monome/40h/monome40h_grid_layout.png

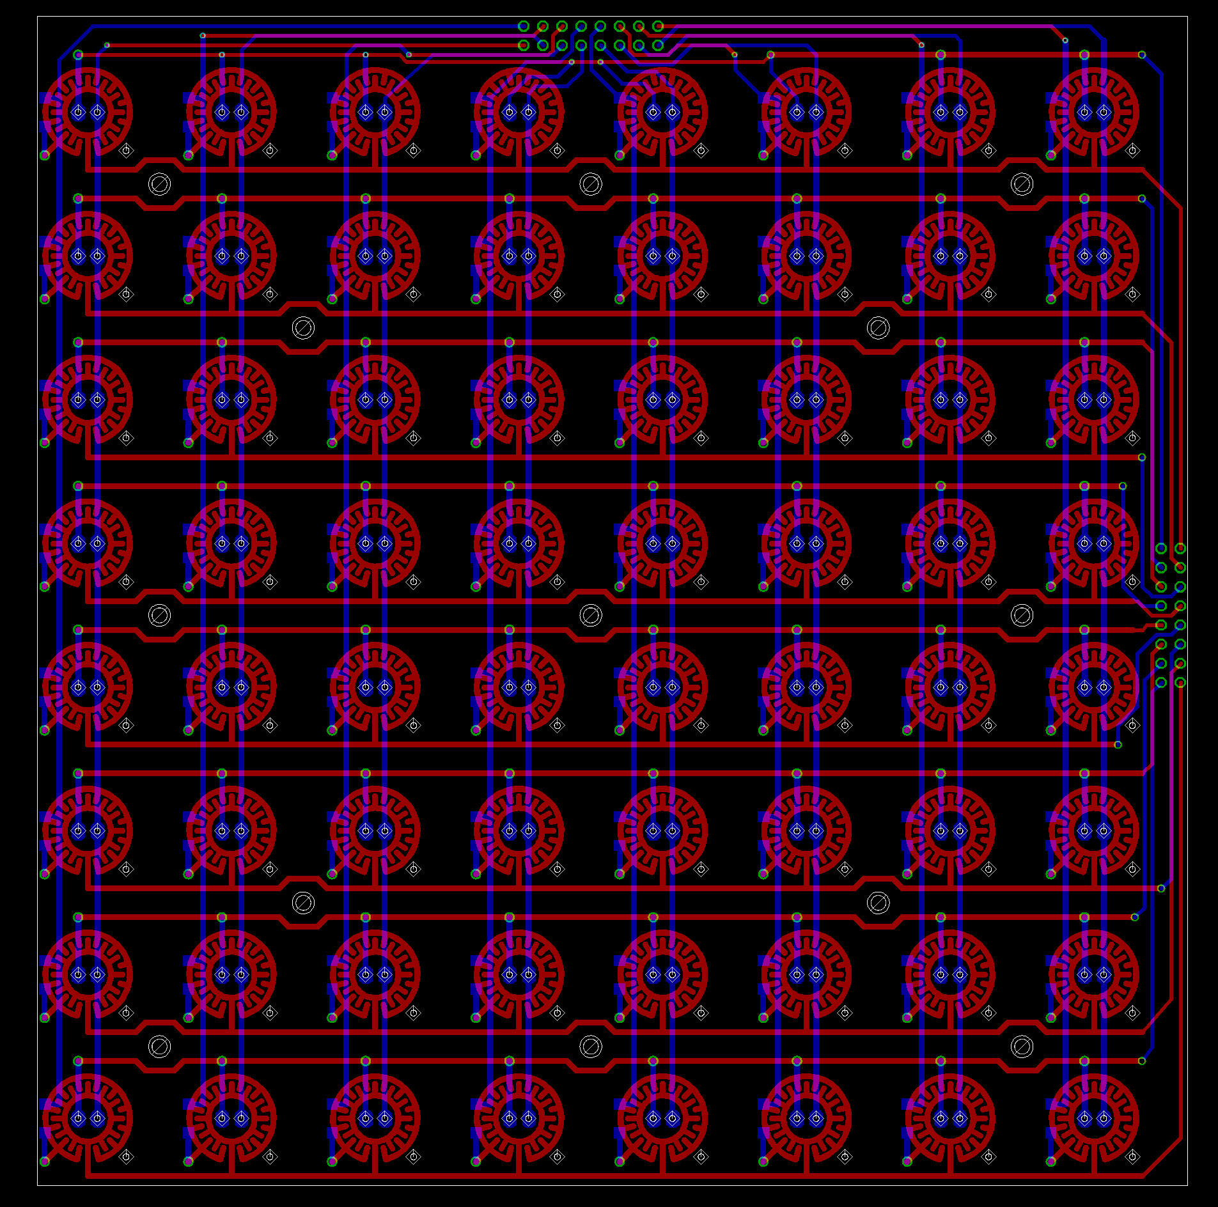
monome40h_grid_layout.png
