monome/40h/monome40h_thrulogic_layout.png

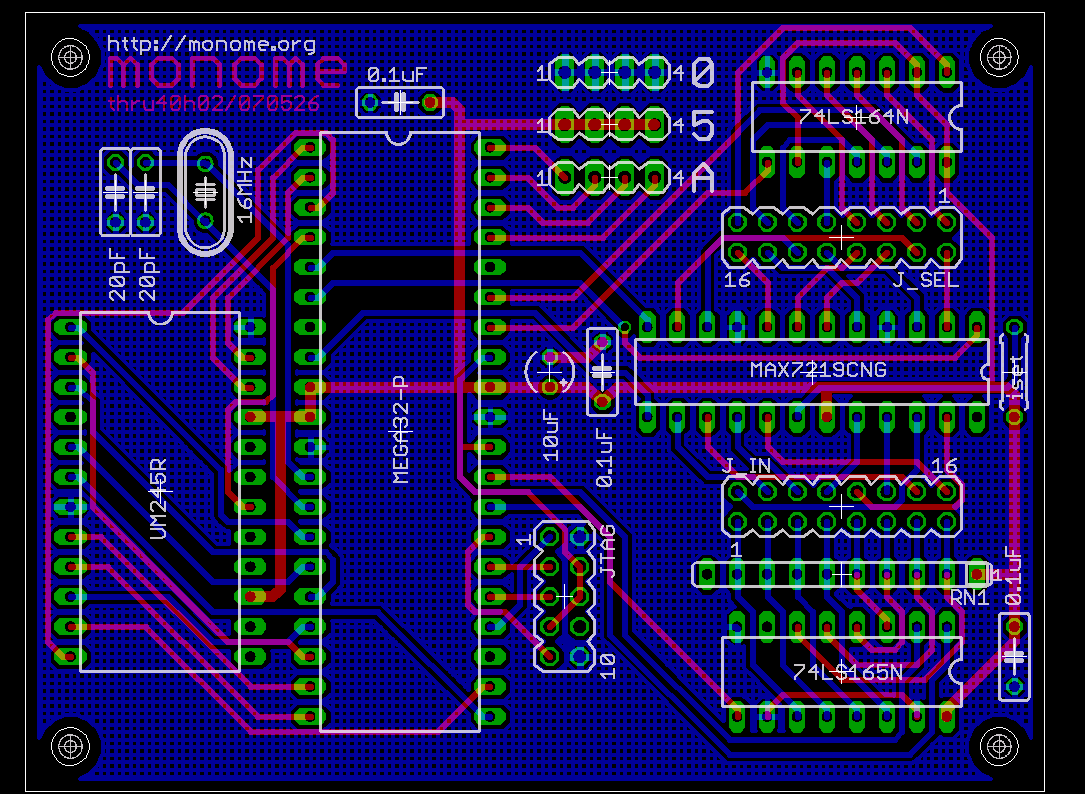
monome40h_thrulogic_layout.png
