monome/40h/monome40h_thrulogic_schem.png

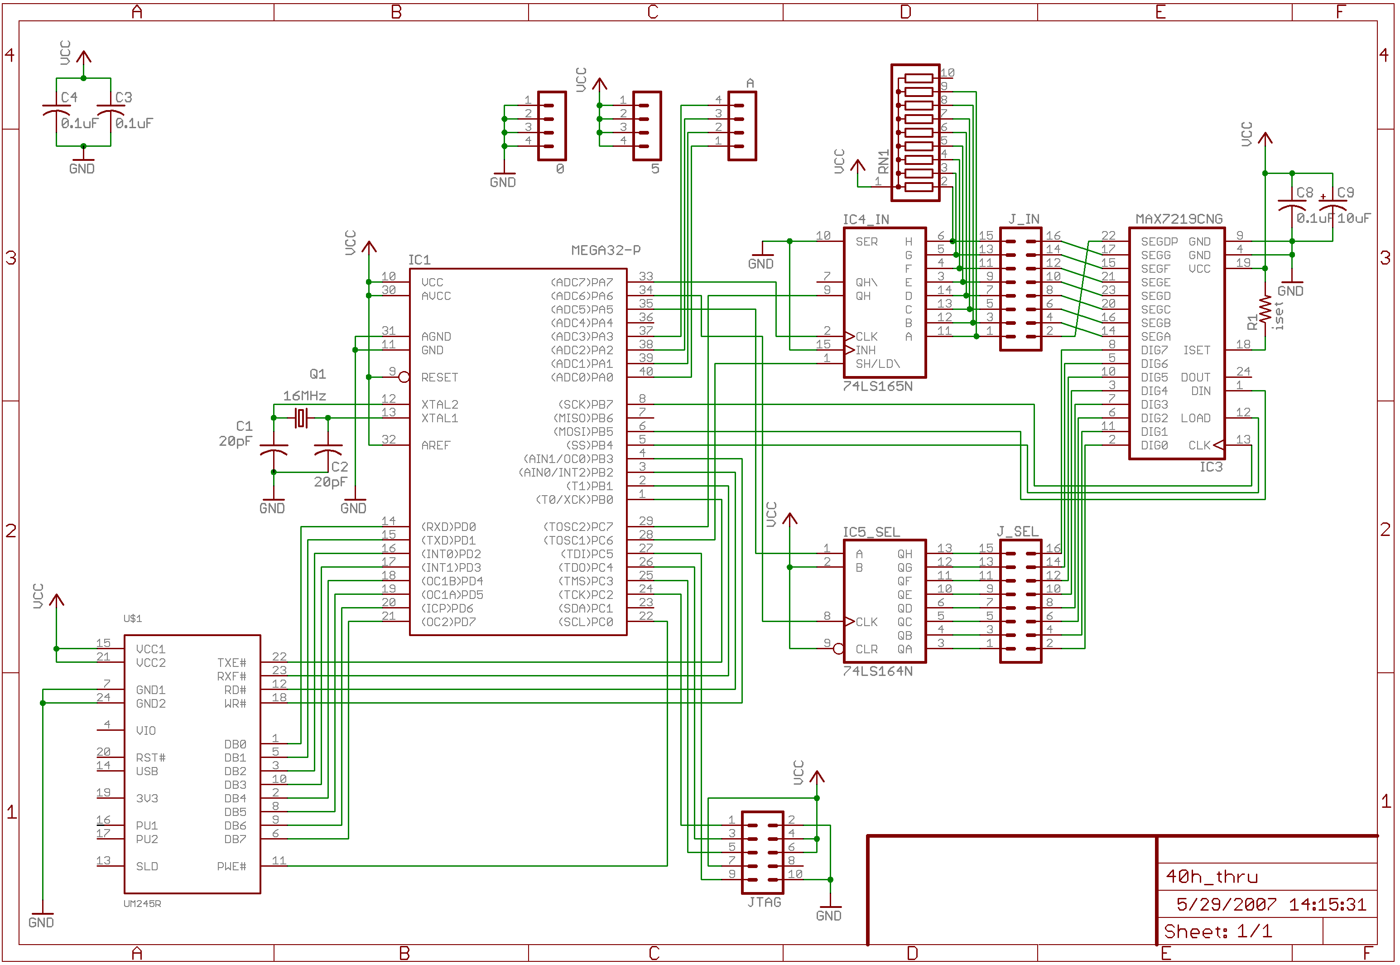
monome40h_thrulogic_schem.png
