monome/40h/40h_partslist.odt

monome 40h thrulogic part list

http://monome.org/40h/kit

q part source partnum

[logic]

1 ftdi um245r ftdi um245

1 atmega32-16pu dk ATMEGA32-16PU

1 max7221cng+ maxim MAX7219CNG+

1 74hc164 dk 296-8248-5-ND

1 74hc165 dk 296-8251-5-N

1 sip-10 res net dk 770-101-R100KP-ND

1 cry16mhz hc49/us dk X1103-ND

3 0.1u cap jameco 151118

2 0.22p cap jameco 15407

1 10u cap dk P975-ND

1 10k res jameco 691104

1 dip40 socket jameco 683227

1 dip24 socket jameco 683163

2 8x2 header jameco 117917

1 5x2 header jameco 117917

[grid]

64 diodes dk 1N4148WTPMSTR

2 8x2 rt-headers jameco 139563

2 ribbon cable jameco 37671

4 ribbon con jameco 119467
