monome/40h/firmware/adc.c

/* 
 *  Copyright (C) 2006, Joe Lake, monome.org
 * 
 *  This file is part of 40h.
 *
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
 *  $Id: adc.c,v. 1.1.1.1 2006/05/02 1:01:22
 */

#include <avr/io.h>
//#include <avr/signal.h>
#include <avr/interrupt.h>
#include "adc.h"


#define adcFilterCheckBucketIndex(index)    if (index >= kAdcFilterNumBuckets) index = 0;
#define checkAdcSelect()                    if (adcSelect >= kAdcFilterNumAdcs) adcSelect = 0;

t_adc_filter gAdcFilters[kAdcFilterNumAdcs];
static uint8 adcSelect = 0;
uint8 gAdcEnableState = 0;


/***************************************************************************************************
 *
 * DESCRIPTION: Initialize filtering software and adc/timer0 hardware.  JAL
 *
 * ARGUMENTS:   
 *
 * RETURNS:
 *
 * NOTES:       
 *
 ****************************************************************************************************/

void initAdcs(void)
{
    initAdcFilters();
    hardInitAdcs();
}


/***************************************************************************************************
 *
 * DESCRIPTION: Stop adc conversions and turn off adcs.
 *
 * ARGUMENTS:   
 *
 * RETURNS:
 *
 * NOTES:       
 *
 ****************************************************************************************************/

void disableAdcs(void)
{
    TIMSK &= ~(1 << TOIE0);  // disable timer0 interrupts
    TCCR0 = 0x00;            // disable timer0

    ADCSRA &= ~(1 << ADATE); // disable conversion auto trigger.
    ADCSRA &= ~(1 << ADEN);  // disable adcs
    ADCSRA &= ~(1 << ADIE);  // disable adc interrupts
}



/***************************************************************************************************
 *
 * DESCRIPTION: Initialize adc/timer0 hardware.  JAL
 *
 * ARGUMENTS:   
 *
 * RETURNS:
 *
 * NOTES:       This function sets up timer0 (automatic reset to 0 on overflow) to run in normal mode at sysclk/64.
 *              Adc conversions are triggered automatically by timer0 overflow.  One thing that is fucked is that
 *              for this to work timer0 interrupts have to be enabled.  I don't think this should be the case
 *              because we don't care about servicing overflow interrupts, we only service the adc conversion finished
 *              interrupts.  As a result I've added "EMPTY_INTERRUPT(SIG_OVERFLOW0)" to this file so we don't hit 
 *              the reset vector when timer0 overflows.  I also think the call to timer_enable_int may disable other timer
 *              interrupts if they're enabled, but I'm not sure.
 *
 ****************************************************************************************************/

void hardInitAdcs(void)
{
    SFIOR |= 0x80;                // set conversion auto trigger source to timer0 overflow

    ADCSRA |= 0x7;          // set adc clock prescaler bits to sysclk/128 to get a conversion clock of 125KHz
                            // (must be between 50Khz and 200Hz).
    ADCSRA |= (1 << ADATE); // enable conversion auto trigger.
    ADCSRA |= (1 << ADEN);  // enable adcs
    ADCSRA |= (1 << ADIE);  // enable adc interrupts

    TCCR0 = 0x04; // enable timer in normal mode.  prescale = /64
    TIMSK |= (1 << TOIE0);  // disable timer0 interrupts
    //TIMSK = (1 << OCIE0);
    //timer_enable_int(_BV(TOIE0));
}


/***************************************************************************************************
 *
 * DESCRIPTION: Zeroes filter structures.  JAL
 *
 * ARGUMENTS:
 *
 * RETURNS:
 *
 * NOTES:       
 *
 ****************************************************************************************************/

void initAdcFilters(void)
{
    uint8 adc, bucket;

    for (adc = 0; adc < kAdcFilterNumAdcs; adc++) {
        gAdcFilters[adc].accum = 0;
        gAdcFilters[adc].value = 0;
        gAdcFilters[adc].index = 0;

        for (bucket = 0; bucket < kAdcFilterNumBuckets; bucket++)
            gAdcFilters[adc].bucket[bucket] = 0;
    }
}


/***************************************************************************************************
 *
 * DESCRIPTION: Adds a new frame to the adc accumulator and genereate a new value.  JAL
 *
 * ARGUMENTS:   adc -   number of adc filter to be updated (0 = PORTA^0, 3 = PORTA^3).
 *              value - 10 bit conversion value (0 = GND, 1023 = AREF.   
 *
 * RETURNS:
 *
 * NOTES:       
 *
 ****************************************************************************************************/
       
void adcAddNextValue(uint8 adc, uint16 value)
{
    gAdcFilters[adc].accum -= gAdcFilters[adc].bucket[gAdcFilters[adc].index];
    gAdcFilters[adc].accum += value;
    gAdcFilters[adc].bucket[gAdcFilters[adc].index] = value;

    gAdcFilters[adc].last_value = gAdcFilters[adc].value;
    gAdcFilters[adc].value = gAdcFilters[adc].accum >> kAdcFilterRightShiftValue;

    gAdcFilters[adc].index++;
    adcFilterCheckBucketIndex(gAdcFilters[adc].index);

    if ((gAdcEnableState & (1 << adc)) && (gAdcFilters[adc].value) != (gAdcFilters[adc].last_value))
        gAdcFilters[adc].dirty = true;
}


/***************************************************************************************************
 *
 * DESCRIPTION: Enables an adc and if all adcs were previously off performs an adc 
 *              hardware init.
 *
 * ARGUMENTS:   adc -   number of adc filter enabled (0 = PORTA^0, 3 = PORTA^3).
 *
 * RETURNS:
 *
 * NOTES:       
 *
 ****************************************************************************************************/

void enableAdc(uint8 adc)
{
    if (adc >= kAdcFilterNumAdcs)
        return;

    if ((gAdcEnableState & 0x0F) == 0)
        initAdcs();

    gAdcEnableState |= (1 << adc);
}


/***************************************************************************************************
 *
 * DESCRIPTION: Disables an adc and if all adcs are off stops adc conversions.
 *
 * ARGUMENTS:   adc -   number of adc filter enabled (0 = PORTA^0, 3 = PORTA^3).
 *
 * RETURNS:
 *
 * NOTES:       
 *
 ****************************************************************************************************/

void disableAdc(uint8 adc)
{
    if (adc >= kAdcFilterNumAdcs)
        return;

    gAdcEnableState &= ~(1 << adc);

    if ((gAdcEnableState & 0x0F) == 0)
        disableAdcs();
}

EMPTY_INTERRUPT(SIG_OVERFLOW0);

SIGNAL(SIG_ADC)
{
    uint16 value;

    value = (uint16)ADCL;
    value |= (((uint16)ADCH) << 8);

    adcAddNextValue(adcSelect, value);

    adcSelect++;
    checkAdcSelect();

    ADMUX &= 0xF0;
    ADMUX |= adcSelect & 0xF;
}
